LuPi13/WATT_BRAKING_CIRCUIT/WATT_Braking_Circuit_ver3.pdf

# ADC2_IN3 Sheet_ver3[1A] V_40

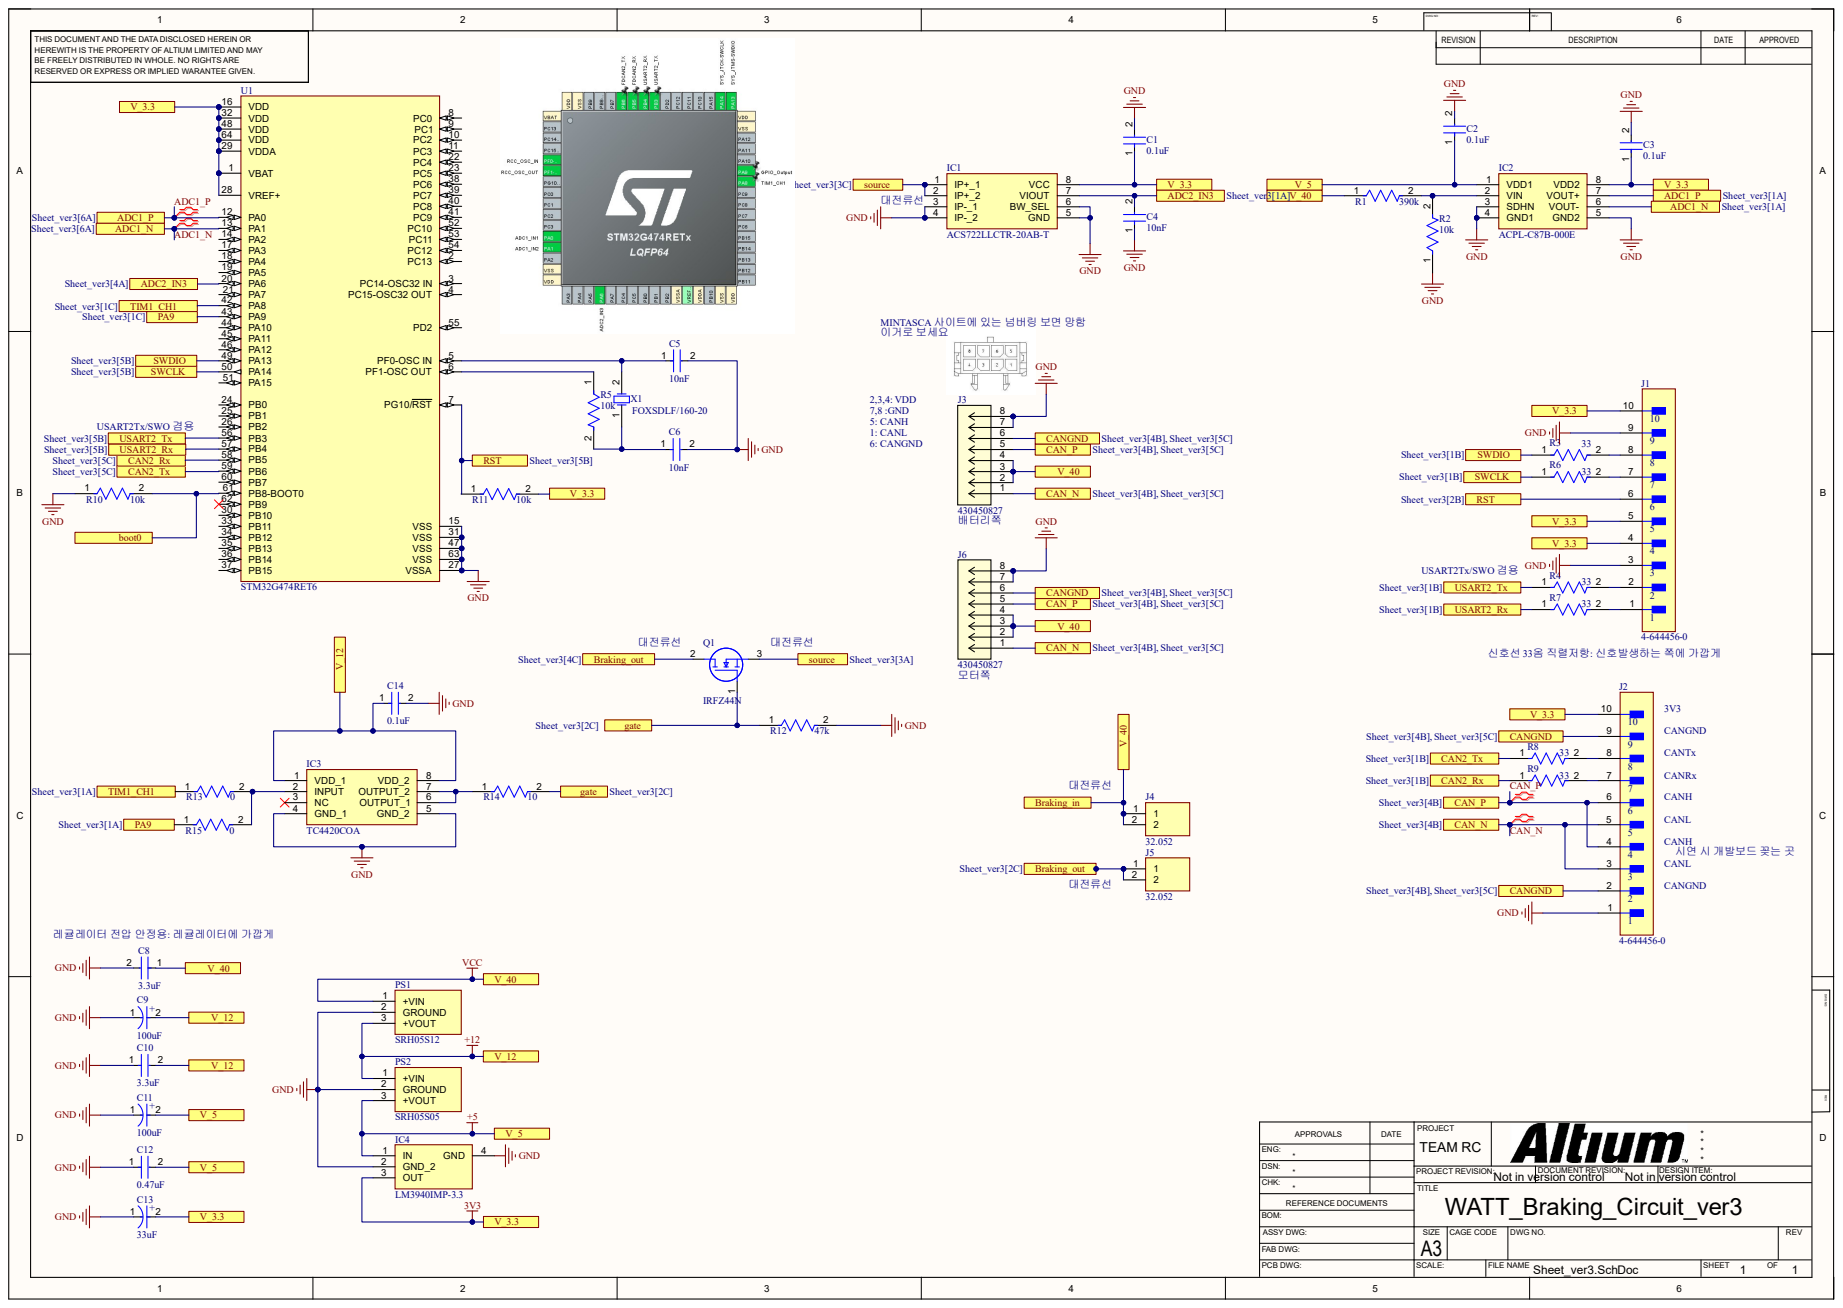
[picture p2: page 1]

1 | 2 | 3 | 4 | 5 | DWG NO: | REV: | 6

THIS DOCUMENT AND THE DATA DISCLOSED HEREIN OR HEREWITH IS THE PROPERTY OF ALTIUM LIMITED AND MAY BE FREELY DISTRIBUTED IN WHOLE. NO RIGHTS ARE RESERVED OR EXPRESS OR IMPLIED WARANTEE GIVEN. | | REVISION | DESCRIPTION | DATE | APPROVED

MINTASCA 사이트에 있는 넘버링 보면 망함
이거로 보세요

신호선 33옴 직렬저항: 신호발생하는 쪽에 가깝게

레귤레이터 전압 안정용: 레귤레이터에 가깝게

APPROVALS | DATE | PROJECT TEAM RC | * *

ENG: *
DSN: * | | PROJECT REVISION: | DOCUMENT REVISION: Not in version control | DESIGN ITEM: Not in version control
CHK: *
