LuPi13/WATT_BRAKING_CIRCUIT/Core/Src/main.c

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
/* Includes ------------------------------------------------------------------*/
#include "main.h"

/* USER CODE BEGIN Includes */
#include <string.h>
#include <stdlib.h>
#include <stdio.h>
/* USER CODE END Includes */

/* USER CODE BEGIN PTD */
typedef enum {
    DEBOUNCING = 0,
    MA = 1,
    LPF = 2,
    RAW = 3
} FilterType;
/* USER CODE END PTD */

/* USER CODE BEGIN PD */
#define VI_BUF_LEN 16

#define ADC1_VOLT_CHANNEL ADC_CHANNEL_1
#define ADC2_CURR_CHANNEL ADC_CHANNEL_3

/* USER CODE END PD */

ADC_HandleTypeDef hadc1;
ADC_HandleTypeDef hadc2;
DMA_HandleTypeDef hdma_adc1;
DMA_HandleTypeDef hdma_adc2;

FDCAN_HandleTypeDef hfdcan2;

TIM_HandleTypeDef htim6;

UART_HandleTypeDef huart2;

/* USER CODE BEGIN PV */
uint16_t v_buf[VI_BUF_LEN]; // ADC1(전압) DMA 버퍼
uint16_t i_buf[VI_BUF_LEN]; // ADC2(전류) DMA 버퍼

// 전압 클램핑 ADC 코드
uint16_t high_th  = 2738; // 43.5V
uint16_t low_th = 2712; // 42.5V

volatile uint8_t gpio_gate_on = 0; // GPIO 제어 핀 상태

// 기본 필터 디바운싱
FilterType filter_mode = DEBOUNCING;

// 디바운싱 설정
static uint8_t debounce_count = 4;  // 연속된 샘플 개수 (변경 가능)
static uint8_t debounce_high_cnt = 0;  // high 임계값 초과 카운터
static uint8_t debounce_low_cnt = 0;   // low 임계값 미만 카운터

uint32_t sampling_freq = 500000;
uint32_t cutoff_freq =  1000;
const float pi =  3.14159265359f;

// 필터된 값
static volatile float filtered_v_code = 0.0f;
static volatile float filtered_i_code = 0.0f;


/* CAN-BUS */
FDCAN_TxHeaderTypeDef TxHeader;
FDCAN_RxHeaderTypeDef RxHeader;
uint8_t TxData[8];
uint8_t RxData[8];

/* USER CODE END PV */

void SystemClock_Config(void);
static void MX_GPIO_Init(void);
static void MX_DMA_Init(void);
static void MX_ADC1_Init(void);
static void MX_ADC2_Init(void);
static void MX_FDCAN2_Init(void);
static void MX_USART2_UART_Init(void);
static void MX_TIM6_Init(void);
/* USER CODE BEGIN PFP */
void ADC_StartAll(void);
/* USER CODE END PFP */

/* USER CODE BEGIN 0 */
// ADC 초기 설정
void ADC_StartAll(void) {
    HAL_ADCEx_Calibration_Start(&hadc1, ADC_DIFFERENTIAL_ENDED);
    HAL_ADCEx_Calibration_Start(&hadc2, ADC_SINGLE_ENDED);

    HAL_ADC_Start_DMA(&hadc1, (uint32_t*)v_buf, VI_BUF_LEN);
    HAL_ADC_Start_DMA(&hadc2, (uint32_t*)i_buf, VI_BUF_LEN);
}

//GPIO 히스테리시스 제어용 (최적화: 직접 레지스터 접근)
static inline void GPIO_GateOn(void) {
    GPIOA->BSRR = GPIO_PIN_9;  // 직접 레지스터 쓰기 (HAL 방식보다 빠름)
    gpio_gate_on = 1;
//    high_th  = 2731; // 43.5V
}
static inline void GPIO_GateOff(void) {
    GPIOA->BSRR = (uint32_t)GPIO_PIN_9 << 16U;  // Reset 비트
    gpio_gate_on = 0;
}

// GPIO 제어핀 상태
static inline uint8_t GPIO_InstantBit(void) {
    return (HAL_GPIO_ReadPin(Gate_GPIO_Port, Gate_Pin) == GPIO_PIN_SET) ? 1u : 0u;
}

// adc값->mV
static inline int16_t Code_to_VmV(uint16_t code) {
    float v_bus = ((float) code - 2048.0) * 3.3f * 40.0f / 2047.0f;
    int32_t mV = (int32_t)(v_bus * 1000.0f + 0.5f);
    if (mV < 0) mV = 0;
    return mV;
}

// adc값->mA
static inline int32_t Code_to_ImA(uint16_t code) {
    float i = (float) code * 3.3f / 4095.0f;
    float I = (i - 1.65f) / 0.066f;
    return (int32_t) (I * 1000.0f);
}


/* ==== UART 명령 ==== */
#define RX_BUFSZ 16
static uint8_t  rx_byte; // Interrupt로 받은 1바이트
static char     rx_line[RX_BUFSZ]; // trim된 데이터 문자열
static uint16_t rx_len = 0; // 커서

// 초기화
void UART_Q_Init(void) {
    rx_len = 0;
    HAL_UART_Receive_IT(&huart2, &rx_byte, 1);
}

// 문자 전송
static inline void UART_SendStr(const char* s) {
    HAL_UART_Transmit(&huart2, (uint8_t*)s, (uint16_t)strlen(s), 20);
}

// 전송받은 문자열 핸들링
static void UART_HandleLine(const char* line_in) {
    // '\r' 제거 및 공백 트림
    char line[RX_BUFSZ];
    size_t L = strnlen(line_in, sizeof(line)-1); // 현재 길이
    while (L && (line_in[L-1]=='\r' || line_in[L-1]==' ' || line_in[L-1]=='\t')) --L; // 공백이나 '\r' 이면 트림
    memcpy(line, line_in, L); line[L] = '\0'; // 문자열 끝에 NULL

    if (strcmp(line, "Q") == 0) { // Q 명령: 현재 V, I, GPIO상태 출력

        // 물리량 환산 (전압/전류 모두 필터링된 값 사용)
        int32_t v_mV = Code_to_VmV((uint16_t)(filtered_v_code + 0.5f));
        int32_t i_mA = Code_to_ImA((uint16_t)(filtered_i_code + 0.5f));

        // 히스테리시스 gate 핀 상태
        uint8_t gpio = GPIO_InstantBit();

        // 한 줄 응답
        char msg[84];
        int n = snprintf(msg, sizeof(msg), "D,%ld,%ld,%u\n",
                         (long)v_mV, (long)i_mA, (unsigned)gpio);
        if (n > 0) HAL_UART_Transmit(&huart2, (uint8_t*)msg, (uint16_t)n, 20);
    }
    else {
        UART_SendStr("ERR\n");
        return; //"Q" 아니면 리턴
    }
}
/* USER CODE END 0 */

/**
  * @brief  The application entry point.
  * @retval int
  */
int main(void)
{

  /* MCU Configuration--------------------------------------------------------*/

  /* Reset of all peripherals, Initializes the Flash interface and the Systick. */
  HAL_Init();

  /* Configure the system clock */
  SystemClock_Config();

  /* Initialize all configured peripherals */
  MX_GPIO_Init();
  MX_DMA_Init();
  MX_ADC1_Init();
  MX_ADC2_Init();
  MX_FDCAN2_Init();
  MX_USART2_UART_Init();
  MX_TIM6_Init();
  /* USER CODE BEGIN 2 */
  ADC_StartAll();
  // BrakePWM_Start();
  // HAL_TIM_Base_Start_IT(&htim7); // PI 제어 사용 안 함
  UART_Q_Init();
  
  // LPF 상태 변수 초기화 (첫 ADC 값으로)
  HAL_Delay(10); // ADC 안정화 대기 (더 길게)
  
  // 여러 샘플 평균으로 초기화 (안정적)
  float sum_v = 0.0f, sum_i = 0.0f;
  for(int n = 0; n < 10; n++) {
      sum_v += (float)HAL_ADC_GetValue(&hadc1);
      sum_i += (float)HAL_ADC_GetValue(&hadc2);
      HAL_Delay(1);
  }
  filtered_v_code = sum_v / 10.0f;
  filtered_i_code = sum_i / 10.0f;
  
  // 로컬 static 변수는 TIM6 콜백 시작 시 자동 초기화됨 (0.0f)
  // 첫 몇 샘플 동안 빠르게 수렴함
  
  // TIM6 인터럽트 시작 (초기화 완료 후)
  HAL_TIM_Base_Start_IT(&htim6);

  /* FDCAN Start */
  if (HAL_FDCAN_Start(&hfdcan2) != HAL_OK) {
      Error_Handler();
  }

  if (HAL_FDCAN_ActivateNotification(&hfdcan2, FDCAN_IT_RX_FIFO0_NEW_MESSAGE, 0) != HAL_OK) {
      Error_Handler();
  }

  /* USER CODE END 2 */

  /* Infinite loop */
  /* USER CODE BEGIN WHILE */
  while (1)
  {
    /* USER CODE END WHILE */

    /* USER CODE BEGIN 3 */
  }
  /* USER CODE END 3 */
}

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
/* USER CODE BEGIN 4 */
/**
  * @brief  FDCAN Rx FIFO 0 수신 콜백
  * @note   ID 0x101 메시지 수신 시 호출됨
  */
void HAL_FDCAN_RxFifo0Callback(FDCAN_HandleTypeDef *hfdcan, uint32_t RxFifo0ITs) {
    if((RxFifo0ITs & FDCAN_IT_RX_FIFO0_NEW_MESSAGE) != RESET) {
        // FIFO 0에서 메시지 수신
        if (HAL_FDCAN_GetRxMessage(hfdcan, FDCAN_RX_FIFO0, &RxHeader, RxData) != HAL_OK) {
            Error_Handler();
        }

        // 메시지 확인 (ID: 0x101)
        if (RxHeader.Identifier == 0x101) {
            // 요청 메시지
            if (RxHeader.DataLength == FDCAN_DLC_BYTES_1 && RxData[0] == 0x01) {
                // 전압, 전류
                uint16_t voltage_mv = (uint16_t)Code_to_VmV((uint16_t)(filtered_v_code + 0.5f));
                uint16_t current_ma = (uint16_t)Code_to_ImA((uint16_t)(filtered_i_code + 0.5f));

                // 핀 상태
                uint8_t pin_status = GPIO_InstantBit();

                // CAN Tx 메시지 설정
                TxHeader.Identifier = 0x100;
                TxHeader.IdType = FDCAN_STANDARD_ID;
                TxHeader.TxFrameType = FDCAN_DATA_FRAME;
                TxHeader.DataLength = FDCAN_DLC_BYTES_5;
                TxHeader.ErrorStateIndicator = FDCAN_ESI_ACTIVE;
                TxHeader.BitRateSwitch = FDCAN_BRS_OFF;
                TxHeader.FDFormat = FDCAN_CLASSIC_CAN;
                TxHeader.TxEventFifoControl = FDCAN_NO_TX_EVENTS;
                TxHeader.MessageMarker = 0;

                // 데이터 패킹 (Big-Endian)
                TxData[0] = (voltage_mv >> 8) & 0xFF;
                TxData[1] = voltage_mv & 0xFF;
                TxData[2] = (current_ma >> 8) & 0xFF;
                TxData[3] = current_ma & 0xFF;
                TxData[4] = pin_status;

                // 메시지 전송
                if (HAL_FDCAN_AddMessageToTxFifoQ(&hfdcan2, &TxHeader, TxData) != HAL_OK) {
                    // 전송 실패
                    Error_Handler();
                }
            }

            // 필터 변경 메시지
            else if (RxHeader.DataLength == FDCAN_DLC_BYTES_2 && RxData[0] == 0x02) {
                if (RxData[1] >= 0 && RxData[1] <= 3) {
                    // 입력받은 필터값으로 변경
                    filter_mode = (FilterType) RxData[1];

                    // CAN Tx 메시지 설정
                    TxHeader.Identifier = 0x100;
                    TxHeader.IdType = FDCAN_STANDARD_ID;
                    TxHeader.TxFrameType = FDCAN_DATA_FRAME;
                    TxHeader.DataLength = FDCAN_DLC_BYTES_2;
                    TxHeader.ErrorStateIndicator = FDCAN_ESI_ACTIVE;
                    TxHeader.BitRateSwitch = FDCAN_BRS_OFF;
                    TxHeader.FDFormat = FDCAN_CLASSIC_CAN;
                    TxHeader.TxEventFifoControl = FDCAN_NO_TX_EVENTS;
                    TxHeader.MessageMarker = 0;

                    // 데이터 패킹 (Big-Endian)
                    TxData[0] = 0x02;
                    TxData[1] = RxData[1];

                    // 메시지 전송
                    if (HAL_FDCAN_AddMessageToTxFifoQ(&hfdcan2, &TxHeader, TxData) != HAL_OK) {
                        // 전송 실패
                        Error_Handler();
                    }
                }

                // 잘못된 값 들어올 경우 에러
                else {
                    // CAN Tx 메시지 설정
                    TxHeader.Identifier = 0x100;
                    TxHeader.IdType = FDCAN_STANDARD_ID;
                    TxHeader.TxFrameType = FDCAN_DATA_FRAME;
                    TxHeader.DataLength = FDCAN_DLC_BYTES_2;
                    TxHeader.ErrorStateIndicator = FDCAN_ESI_ACTIVE;
                    TxHeader.BitRateSwitch = FDCAN_BRS_OFF;
                    TxHeader.FDFormat = FDCAN_CLASSIC_CAN;
                    TxHeader.TxEventFifoControl = FDCAN_NO_TX_EVENTS;
                    TxHeader.MessageMarker = 0;

                    // 데이터 패킹 (Big-Endian)
                    TxData[0] = 0x02;
                    TxData[1] = 0x00;

                    // 메시지 전송
                    if (HAL_FDCAN_AddMessageToTxFifoQ(&hfdcan2, &TxHeader, TxData) != HAL_OK) {
                        // 전송 실패
                        Error_Handler();
                    }
                }
            }

            // LPF 차단주파수 설정
            else if (RxHeader.DataLength == FDCAN_DLC_BYTES_5 && RxData[0] == 0x03) {
                cutoff_freq =
                            ((uint32_t)RxData[1] << 24) |
                            ((uint32_t)RxData[2] << 16) |
                            ((uint32_t)RxData[3] << 8)  |
                            (uint32_t)RxData[4];

                // CAN Tx 메시지 설정
                TxHeader.Identifier = 0x100;
                TxHeader.IdType = FDCAN_STANDARD_ID;
                TxHeader.TxFrameType = FDCAN_DATA_FRAME;
                TxHeader.DataLength = FDCAN_DLC_BYTES_5;
                TxHeader.ErrorStateIndicator = FDCAN_ESI_ACTIVE;
                TxHeader.BitRateSwitch = FDCAN_BRS_OFF;
                TxHeader.FDFormat = FDCAN_CLASSIC_CAN;
                TxHeader.TxEventFifoControl = FDCAN_NO_TX_EVENTS;
                TxHeader.MessageMarker = 0;

                // 데이터 패킹 (Big-Endian)
                for (int i = 0; i <= 4; i++) {
                    TxData[i] = RxData[i];
                }

                // 메시지 전송
                if (HAL_FDCAN_AddMessageToTxFifoQ(&hfdcan2, &TxHeader, TxData) != HAL_OK) {
                    // 전송 실패
                    Error_Handler();
                }
            }

            // high_th 설정
            else if (RxHeader.DataLength == FDCAN_DLC_BYTES_3 && RxData[0] == 0x04) {
                high_th =
                            ((uint32_t)RxData[1] << 8) |
                            (uint32_t)RxData[2];

                // CAN Tx 메시지 설정
                TxHeader.Identifier = 0x100;
                TxHeader.IdType = FDCAN_STANDARD_ID;
                TxHeader.TxFrameType = FDCAN_DATA_FRAME;
                TxHeader.DataLength = FDCAN_DLC_BYTES_3;
                TxHeader.ErrorStateIndicator = FDCAN_ESI_ACTIVE;
                TxHeader.BitRateSwitch = FDCAN_BRS_OFF;
                TxHeader.FDFormat = FDCAN_CLASSIC_CAN;
                TxHeader.TxEventFifoControl = FDCAN_NO_TX_EVENTS;
                TxHeader.MessageMarker = 0;

                // 데이터 패킹 (Big-Endian)
                for (int i = 0; i <= 2; i++) {
                    TxData[i] = RxData[i];
                }

                // 메시지 전송
                if (HAL_FDCAN_AddMessageToTxFifoQ(&hfdcan2, &TxHeader, TxData) != HAL_OK) {
                    // 전송 실패
                    Error_Handler();
                }
            }

            // low_th 설정
            else if (RxHeader.DataLength == FDCAN_DLC_BYTES_3 && RxData[0] == 0x05) {
                low_th =
                            ((uint32_t)RxData[1] << 8) |
                            (uint32_t)RxData[2];

                // CAN Tx 메시지 설정
                TxHeader.Identifier = 0x100;
                TxHeader.IdType = FDCAN_STANDARD_ID;
                TxHeader.TxFrameType = FDCAN_DATA_FRAME;
                TxHeader.DataLength = FDCAN_DLC_BYTES_3;
                TxHeader.ErrorStateIndicator = FDCAN_ESI_ACTIVE;
                TxHeader.BitRateSwitch = FDCAN_BRS_OFF;
                TxHeader.FDFormat = FDCAN_CLASSIC_CAN;
                TxHeader.TxEventFifoControl = FDCAN_NO_TX_EVENTS;
                TxHeader.MessageMarker = 0;

                // 데이터 패킹 (Big-Endian)
                for (int i = 0; i <= 2; i++) {
                    TxData[i] = RxData[i];
                }

                // 메시지 전송
                if (HAL_FDCAN_AddMessageToTxFifoQ(&hfdcan2, &TxHeader, TxData) != HAL_OK) {
                    // 전송 실패
                    Error_Handler();
                }
            }
        }
    }
}

/**
 * @brief ADC Half Transfer Complete Callback (DMA 버퍼 앞 절반 채워짐)
 * @note MA 모드일 때 앞 절반 평균 계산
 */
void HAL_ADC_ConvHalfCpltCallback(ADC_HandleTypeDef* hadc) {
    if (filter_mode == MA) {
        if (hadc->Instance == ADC1) {
            // v_buf 앞 절반의 평균
            float v_add = 0.0f;
            for (int i = 0; i <= (VI_BUF_LEN/2-1); i++) {
                v_add += v_buf[i];
            }
            filtered_v_code = v_add / (((float) VI_BUF_LEN) / 2.0f);
        }
        else if (hadc->Instance == ADC2) {
            // i_buf 앞 절반의 평균
            float i_add = 0.0f;
            for (int i = 0; i <= (VI_BUF_LEN/2-1); i++) {
                i_add += i_buf[i];
            }
            filtered_i_code = i_add / (((float) VI_BUF_LEN) / 2.0f);
        }
    }
}
/**
 * @brief ADC Transfer Complete Callback (DMA 버퍼 전체 채워짐)
 * @note MA 모드일 때 뒤 절반 평균 계산
 */
void HAL_ADC_ConvCpltCallback(ADC_HandleTypeDef* hadc) {
    if (filter_mode == MA) {
        if (hadc->Instance == ADC1) {
            // v_buf 뒤 절반의 평균
            float v_add = 0.0f;
            for (int i = VI_BUF_LEN/2; i <= (VI_BUF_LEN-1); i++) {
                v_add += v_buf[i];
            }
            filtered_v_code = v_add / (((float) VI_BUF_LEN) / 2.0f);
        }
        else if (hadc->Instance == ADC2) {
            // i_buf 뒤 절반의 평균
            float i_add = 0.0f;
            for (int i = VI_BUF_LEN/2; i <= (VI_BUF_LEN-1); i++) {
                i_add += i_buf[i];
            }
            filtered_i_code = i_add / (((float) VI_BUF_LEN) / 2.0f);
        }
    }
}

/**
 * @brief TIM_period 콜백함수
 * @note TIM6: LPF 및 히스테리시스 제어
 */
void HAL_TIM_PeriodElapsedCallback(TIM_HandleTypeDef *htim) {
    if (htim->Instance == TIM6) {
        // ADC 값 읽기
        uint16_t v = (uint16_t) HAL_ADC_GetValue(&hadc1);
        uint16_t i = (uint16_t) HAL_ADC_GetValue(&hadc2);

        // LPF 적용 (float, 전역 변수 직접 사용)
        if (filter_mode == LPF) {
            float lpf_alpha = ((2.0f * pi * (float) cutoff_freq) / (((float) sampling_freq) + 2.0f * pi * ((float) cutoff_freq)));
            filtered_v_code += lpf_alpha * ((float)v - filtered_v_code);
            filtered_i_code += lpf_alpha * ((float)i - filtered_i_code);
        }
        // raw나 debouncing이면 filtered 값에 그대로 전달
        else if (filter_mode == RAW || filter_mode == DEBOUNCING) {
            filtered_v_code = v;
            filtered_i_code = i;
        }

        // 디바운싱: 연속된 N개 샘플이 임계값을 넘어야 동작
        if (filter_mode == DEBOUNCING) {
            if (!gpio_gate_on) {
                if (v > high_th) {
                    debounce_high_cnt++;
                    debounce_low_cnt = 0;  // 반대쪽 카운터 리셋

                    if (debounce_high_cnt >= debounce_count) {
                        GPIO_GateOn();
                        debounce_high_cnt = 0;  // 카운터 리셋
                    }
                } else {
                    debounce_high_cnt = 0;  // 조건 불만족 시 리셋
                }
            }
            else {  // gpio_gate_on == 1
                if (v < low_th) {
                    debounce_low_cnt++;
                    debounce_high_cnt = 0;  // 반대쪽 카운터 리셋

                    if (debounce_low_cnt >= debounce_count) {
                        GPIO_GateOff();
                        debounce_low_cnt = 0;  // 카운터 리셋
                    }
                } else {
                    debounce_low_cnt = 0;  // 조건 불만족 시 리셋
                }
            }
        }

        // 이외의 경우, 필터값이 임계값 넘기면 동작
        if (!gpio_gate_on && filtered_v_code > high_th) {
            GPIO_GateOn();
        }
        else if (gpio_gate_on && filtered_v_code < low_th) {
            GPIO_GateOff();
        }
    }
}

/**
 * @brief UART 수신 콜백함수
 * @note USART2: UART 모니터링부
 */
void HAL_UART_RxCpltCallback(UART_HandleTypeDef *huart) {
    if (huart->Instance == USART2) {
        uint8_t b = rx_byte; // 받은 1바이트 데이터
        if (b == '\n' || rx_len >= (RX_BUFSZ - 1)) { // EOL 또는 배열 끝
            rx_line[rx_len] = '\0'; // '\0' 문자열 끝 처리
            if (rx_len) UART_HandleLine(rx_line); // 해당 버퍼의 문자열 처리
            rx_len = 0; // 커서 초기화
        } else {
            if (b != '\r') rx_line[rx_len++] = (char)b; // '\r'이 아닌 글자면 수신버퍼에 저장 후 커서 1 증가
        }
        HAL_UART_Receive_IT(&huart2, &rx_byte, 1); // 계속 수신
    }
}
/* USER CODE END 4 */
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
