LuPi13/WATT_BRAKING_CIRCUIT/watt_braking_circuit1.ioc

Mcu.UserName=STM32G474RETx
PA0.Signal=ADC1_IN1
PA1.Signal=ADC1_IN2
PA13.Signal=SYS_JTMS-SWDIO
PA14.Signal=SYS_JTCK-SWCLK
PA6.Signal=ADC2_IN3
PA8.Signal=S_TIM1_CH1
PA9.GPIO_Label=Gate
PA9.Signal=GPIO_Output
PB3.Signal=USART2_TX
PB4.Signal=USART2_RX
PB5.Signal=FDCAN2_RX
PB6.Signal=FDCAN2_TX
PF0-OSC_IN.Signal=RCC_OSC_IN
PF1-OSC_OUT.Signal=RCC_OSC_OUT
