LuPi13/WATT_BRAKING_CIRCUIT/(commit log)

2025-11-12 Commentize PWM control
2025-11-12 Add LPF for sensors
2025-11-14 Remove all PWM-related code
2025-11-17 Modify clocks and timings Main clock 170MHz, ADC sampling 500kHz
2025-11-18 Use debouncing logic
    All system stabilized.
    [main.c, watt_braking_circuit1.ioc]
2025-11-18 Add MA in DMA half-pingpong Function
2025-11-18 Redesign CAN data format
    [0-1]: V_mV
    [2-3]: I_mA
    [4]: Pinstate
    [main.c]
2025-11-18 Add four filter type
2025-11-18 Add CAN control command
    101 2 02 (00-03): Change filter
    101 5 03 (big-endian cutoff_freq)[4]: Change cutoff frequency of LPF
2025-11-19 Fix not calculating MA
    [main.c]
